ayuusweetfish/AICHO/hw/AICHO.kicad_pcb

## KiCad design hw/AICHO.kicad_pcb (2024-06-06)

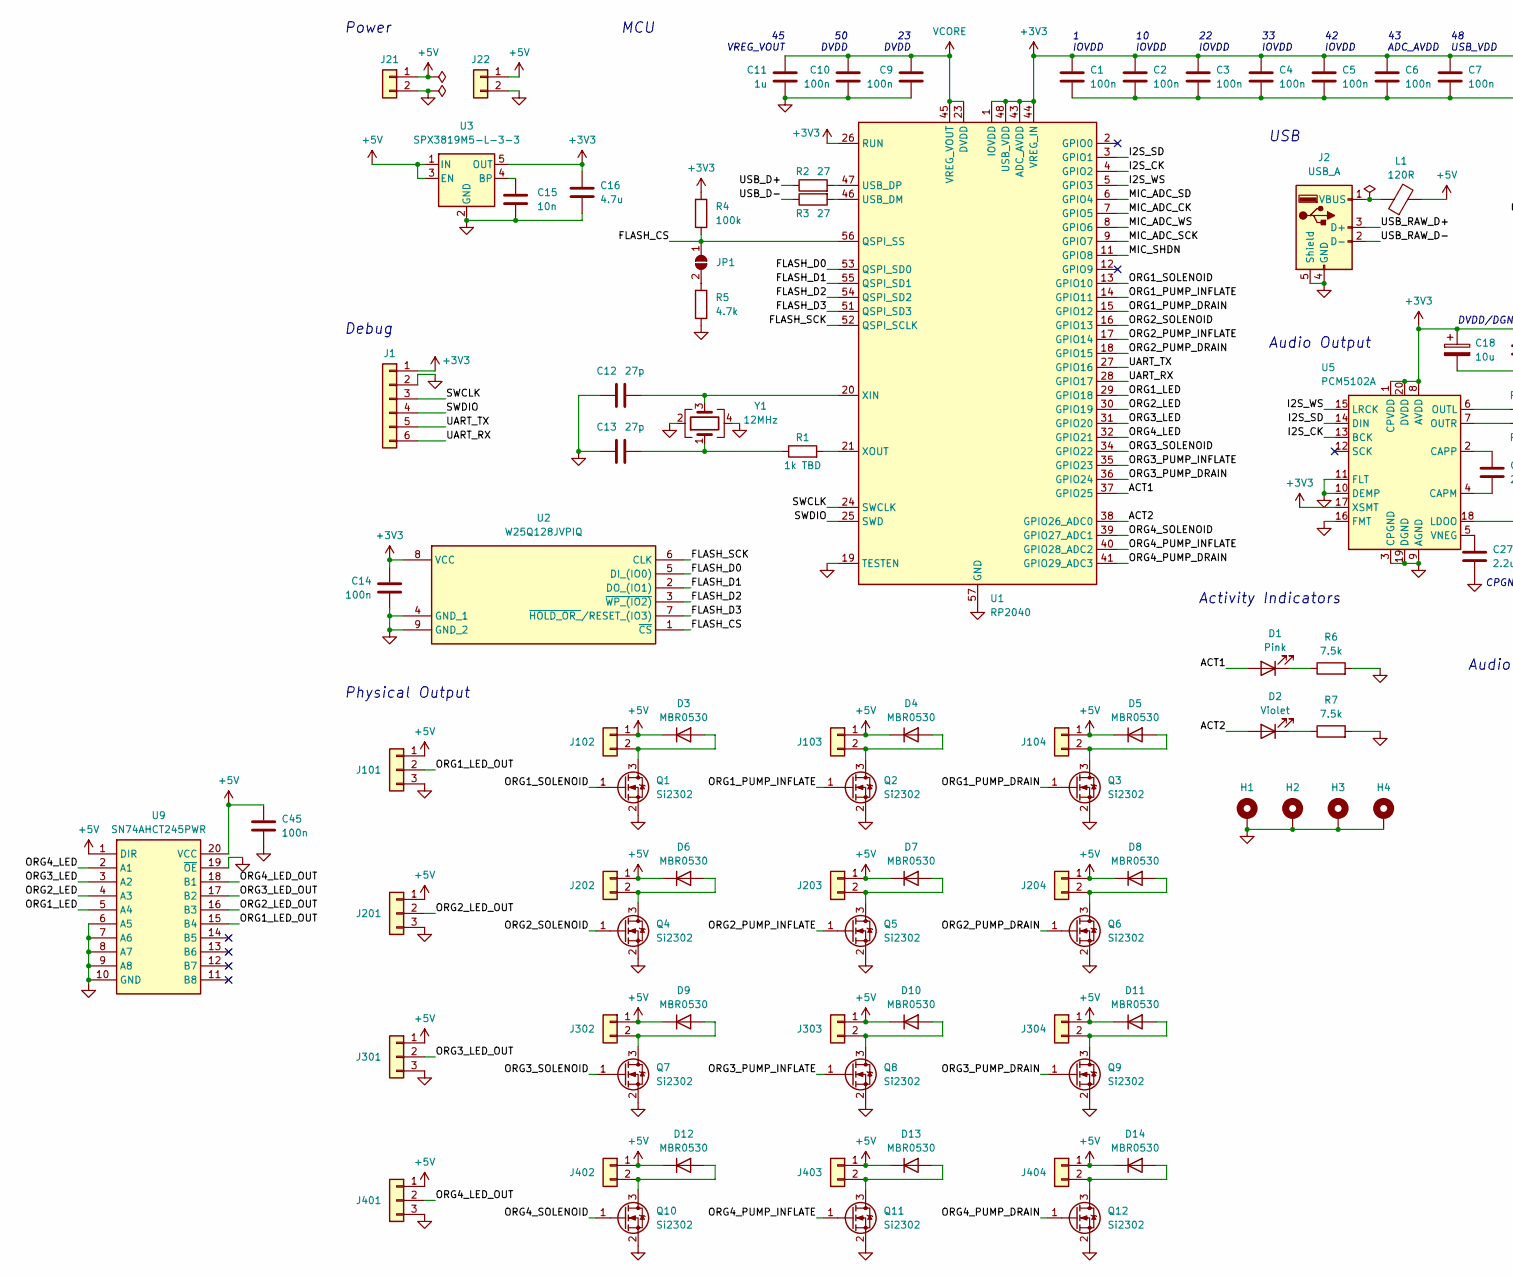
[picture p1: schematic AICHO.kicad_sch, part in row 1, column 1]

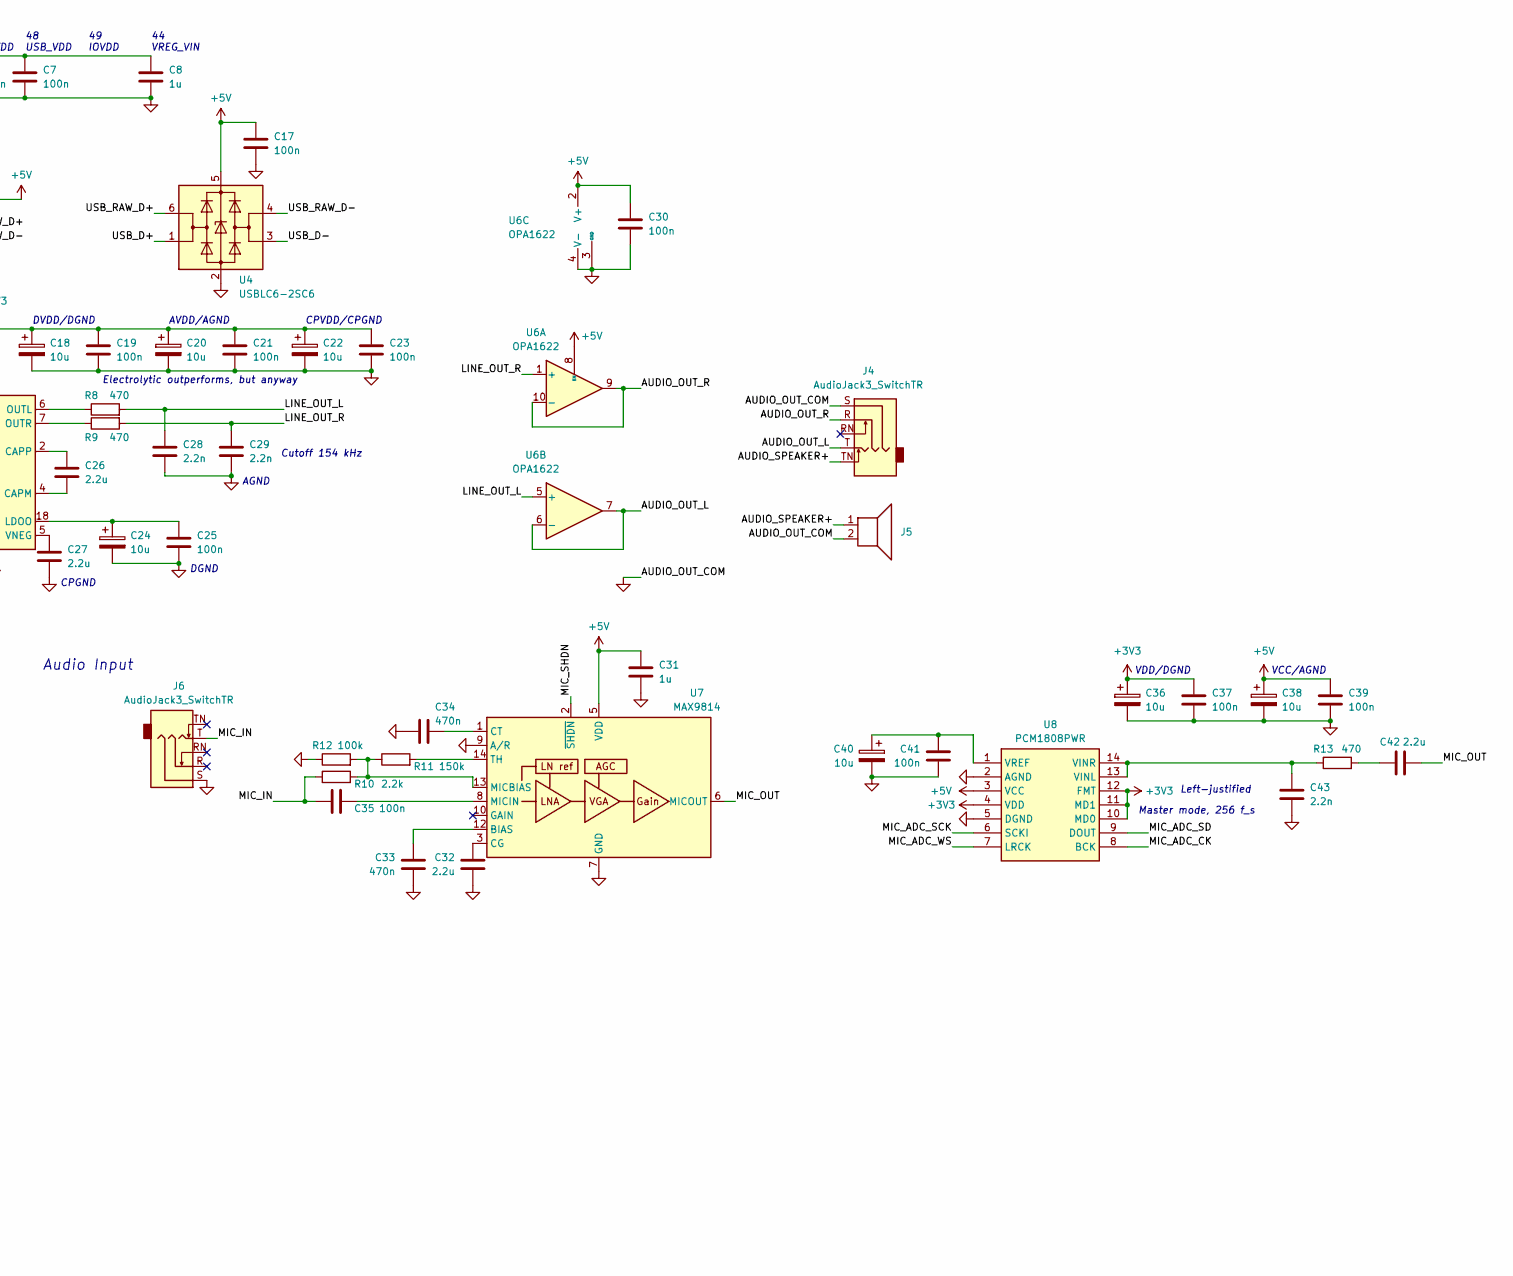
[picture p2: schematic AICHO.kicad_sch, part in row 1, column 2]

Parts:
C1, C2, C3, C4, C5, C6, C7, C9, C10, C14, C17, C19, C21, C23, C25, C30, C35, C37, C39, C41, C45: 100n; C_0402_1005Metric
C8, C11, C31: 1u; C_0402_1005Metric
C12, C13: 27p; C_0402_1005Metric
C15: 10n; C_0603_1608Metric
C16: 4.7u; C_0603_1608Metric
C18, C20, C22, C24, C36, C38, C40: 10u; C_0603_1608Metric
C26, C27, C32, C42: 2.2u; C_0402_1005Metric
C28, C29, C43: 2.2n; C_0402_1005Metric
C33, C34: 470n; C_0402_1005Metric
D1: Pink; LED_0603_1608Metric
D2: Violet; LED_0603_1608Metric
D3, D4, D5, D6, D7, D8, D9, D10, D11, D12, D13, D14: MBR0530; D_SOD-123
H1, H2, H3, H4: MountingHole_Pad; MountingHole_2.5mm_Pad_Via
J1: Conn_01x06; TestPoints_1x06_P2.0
J2: USB_A; USB_A_CNCTech_1001-011-01101_Horizontal
J4, J6: AudioJack3_SwitchTR; Jack_3.5mm_CUI_SJ1-3525N_Horizontal
J5: Speaker; PinHeader_1x02_P2.54mm_Vertical
J21, J22, J102, J103, J104, J202, J203, J204, J302, J303, J304, J402, J403, J404: Conn_01x02; PinHeader_1x02_P2.54mm_Vertical
J101, J201, J301, J401: Conn_01x03; PinHeader_1x03_P2.54mm_Vertical
JP1: SolderJumper_2_Open; SolderJumper-2_P1.3mm_Open_RoundedPad1.0x1.5mm
L1: 120R; L_0805_2012Metric
Q1, Q2, Q3, Q4, Q5, Q6, Q7, Q8, Q9, Q10, Q11, Q12: Si2302; SOT-23
R1: 1k TBD; R_0603_1608Metric
R2, R3: 27; R_0603_1608Metric
R4: 100k; R_0603_1608Metric
R5: 4.7k; R_0603_1608Metric
R6, R7: 7.5k; R_0603_1608Metric
R8, R9, R13: 470; R_0402_1005Metric
R10: 2.2k; R_0402_1005Metric
R11: 150k; R_0402_1005Metric
R12: 100k; R_0402_1005Metric
U1: RP2040; QFN-56-1EP_7x7mm_P0.4mm_EP3.2x3.2mm
U2: W25Q128JVPIQ; SON127P600X500X80-9N-D; Manufacturer_Part_Number W25Q128JVPIQ; Mouser Part Number 454-W25Q128JVPIQ
U3: SPX3819M5-L-3-3; SOT-23-5
U4: USBLC6-2SC6; SOT-23-6
U5: PCM5102A; TSSOP-20_4.4x6.5mm_P0.65mm
U6: OPA1622; Texas_S-PVSON-N10
U7: MAX9814; DFN-14-1EP_3x3mm_P0.4mm_EP1.78x2.35mm
U8: PCM1808PWR; Manufacturer_Part_Number PCM1808PWR; Mouser Part Number 595-PCM1808PWR
U9: SN74AHCT245PWR; SOP65P640X120-20N; Manufacturer_Part_Number SN74AHCT245PWR; Mouser Part Number 595-SN74AHCT245PWR
Y1: 12MHz; Crystal_SMD_3225-4Pin_3.2x2.5mm

Connections:
+3V3: C1.1, C2.1, C3.1, C4.1, C5.1, C6.1, C7.1, C8.1, C14.1, C16.1, C18.1, C19.1, C20.1, C21.1, C22.1, C23.1, C36.1, C37.1, J1.1, R4.2, U1.1 (IOVDD), U1.10 (IOVDD), U1.22 (IOVDD), U1.26 (RUN), U1.33 (IOVDD), U1.42 (IOVDD), U1.43 (ADC_AVDD), U1.44 (VREG_IN), U1.48 (USB_VDD), U1.49 (IOVDD), U2.8 (VCC), U3.5 (OUT), U5.1 (CPVDD), U5.8 (AVDD), U5.17 (XSMT), U5.20 (DVDD), U8.4 (VDD), U8.10 (MD0), U8.11 (MD1), U8.12 (FMT)
+5V: C17.1, C30.1, C31.1, C38.1, C39.1, C45.1, D3.1 (K), D4.1 (K), D5.1 (K), D6.1 (K), D7.1 (K), D8.1 (K), D9.1 (K), D10.1 (K), D11.1 (K), D12.1 (K), D13.1 (K), D14.1 (K), J21.1, J22.1, J101.1, J102.1, J103.1, J104.1, J201.1, J202.1, J203.1, J204.1, J301.1, J302.1, J303.1, J304.1, J401.1, J402.1, J403.1, J404.1, L1.2, U3.1 (IN), U3.3 (EN), U4.5 (VBUS), U6.2 (V+), U6.8 (EN), U7.5 (VDD), U8.3 (VCC), U9.1 (DIR), U9.20 (VCC)
/ACT1: D1.2 (A), U1.37 (GPIO25)
/ACT2: D2.2 (A), U1.38 (GPIO26_ADC0)
/AUDIO_OUT_L: J4.T, U6.6 (-), U6.7
/AUDIO_OUT_R: J4.R, U6.9, U6.10 (-)
/AUDIO_SPEAKER+: J4.TN, J5.1
/FLASH_CS: JP1.1 (A), R4.1, U1.56 (QSPI_SS), U2.1 (~CS)
/FLASH_D0: U1.53 (QSPI_SD0), U2.5 (DI_(IO0))
/FLASH_D1: U1.55 (QSPI_SD1), U2.2 (DO_(IO1))
/FLASH_D2: U1.54 (QSPI_SD2), U2.3 (~WP_(IO2))
/FLASH_D3: U1.51 (QSPI_SD3), U2.7 (~HOLD_OR_/RESET_(IO3))
/FLASH_SCK: U1.52 (QSPI_SCLK), U2.6 (CLK)
/I2S_CK: U1.4 (GPIO2), U5.13 (BCK)
/I2S_SD: U1.3 (GPIO1), U5.14 (DIN)
/I2S_WS: U1.5 (GPIO3), U5.15 (LRCK)
/LINE_OUT_L: C28.1, R8.2, U6.5 (+)
/LINE_OUT_R: C29.1, R9.2, U6.1 (+)
/MIC_ADC_CK: U1.7 (GPIO5), U8.8 (BCK)
/MIC_ADC_SCK: U1.9 (GPIO7), U8.6 (SCKI)
/MIC_ADC_SD: U1.6 (GPIO4), U8.9 (DOUT)
/MIC_ADC_WS: U1.8 (GPIO6), U8.7 (LRCK)
/MIC_IN: C35.1, J6.T, R10.1
/MIC_OUT: C42.2, U7.6 (MICOUT)
/MIC_SHDN: U1.11 (GPIO8), U7.2 (~SHDN)
/ORG1_LED: U1.29 (GPIO18), U9.5 (A4)
/ORG1_LED_OUT: J101.2, U9.15 (B4)
/ORG1_PUMP_DRAIN: Q3.1 (G), U1.15 (GPIO12)
/ORG1_PUMP_INFLATE: Q2.1 (G), U1.14 (GPIO11)
/ORG1_SOLENOID: Q1.1 (G), U1.13 (GPIO10)
/ORG2_LED: U1.30 (GPIO19), U9.4 (A3)
/ORG2_LED_OUT: J201.2, U9.16 (B3)
/ORG2_PUMP_DRAIN: Q6.1 (G), U1.18 (GPIO15)
/ORG2_PUMP_INFLATE: Q5.1 (G), U1.17 (GPIO14)
/ORG2_SOLENOID: Q4.1 (G), U1.16 (GPIO13)
/ORG3_LED: U1.31 (GPIO20), U9.3 (A2)
/ORG3_LED_OUT: J301.2, U9.17 (B2)
/ORG3_PUMP_DRAIN: Q9.1 (G), U1.36 (GPIO24)
/ORG3_PUMP_INFLATE: Q8.1 (G), U1.35 (GPIO23)
/ORG3_SOLENOID: Q7.1 (G), U1.34 (GPIO22)
/ORG4_LED: U1.32 (GPIO21), U9.2 (A1)
/ORG4_LED_OUT: J401.2, U9.18 (B1)
/ORG4_PUMP_DRAIN: Q12.1 (G), U1.41 (GPIO29_ADC3)
/ORG4_PUMP_INFLATE: Q11.1 (G), U1.40 (GPIO28_ADC2)
/ORG4_SOLENOID: Q10.1 (G), U1.39 (GPIO27_ADC1)
/SWCLK: J1.3, U1.24 (SWCLK)
/SWDIO: J1.4, U1.25 (SWD)
/UART_RX: J1.6, U1.28 (GPIO17)
/UART_TX: J1.5, U1.27 (GPIO16)
/USB_D+: R2.1, U4.1 (I/O1)
/USB_D-: R3.1, U4.3 (I/O2)
/USB_RAW_D+: J2.3 (D+), U4.6 (I/O1)
/USB_RAW_D-: J2.2 (D-), U4.4 (I/O2)
GND: C1.2, C2.2, C3.2, C4.2, C5.2, C6.2, C7.2, C8.2, C9.2, C10.2, C11.2, C12.1, C13.1, C14.2, C15.2, C16.2, C17.2, C18.2, C19.2, C20.2, C21.2, C22.2, C23.2, C24.2, C25.2, C27.2, C28.2, C29.2, C30.2, C31.2, C32.2, C33.2, C34.2, C36.2, C37.2, C38.2, C39.2, C40.2, C41.2, C43.2, C45.2, H1.1, H2.1, H3.1, H4.1, J1.2, J2.4 (GND), J2.5 (Shield), J4.S, J5.2, J6.S, J21.2, J22.2, J101.3, J201.3, J301.3, J401.3, Q1.2 (S), Q2.2 (S), Q3.2 (S), Q4.2 (S), Q5.2 (S), Q6.2 (S), Q7.2 (S), Q8.2 (S), Q9.2 (S), Q10.2 (S), Q11.2 (S), Q12.2 (S), R5.1, R6.2, R7.2, R12.1, U1.19 (TESTEN), U1.57 (GND), U2.4 (GND_1), U2.9 (GND_2), U3.2 (GND), U4.2 (GND), U5.3 (CPGND), U5.9 (AGND), U5.10 (DEMP), U5.11 (FLT), U5.16 (FMT), U5.19 (DGND), U6.3 (GND), U6.4 (V-), U6.11 (V-), U7.4 (GND), U7.7 (GND), U7.9 (A/R), U7.11 (GND), U7.15 (GND), U8.2 (AGND), U8.5 (DGND), U9.6 (A5), U9.7 (A6), U9.8 (A7), U9.9 (A8), U9.10 (GND), U9.19 (~OE), Y1.2, Y1.4
unnamed: C13.2, R1.1, Y1.1
unnamed: C42.1, R13.2
unnamed: D1.1 (K), R6.1
unnamed: D2.1 (K), R7.1
unnamed: D3.2 (A), J102.2, Q1.3 (D)
unnamed: D4.2 (A), J103.2, Q2.3 (D)
unnamed: D5.2 (A), J104.2, Q3.3 (D)
unnamed: D6.2 (A), J202.2, Q4.3 (D)
unnamed: D7.2 (A), J203.2, Q5.3 (D)
unnamed: D8.2 (A), J204.2, Q6.3 (D)
unnamed: D9.2 (A), J302.2, Q7.3 (D)
unnamed: D10.2 (A), J303.2, Q8.3 (D)
unnamed: D11.2 (A), J304.2, Q9.3 (D)
unnamed: D12.2 (A), J402.2, Q10.3 (D)
unnamed: D13.2 (A), J403.2, Q11.3 (D)
unnamed: D14.2 (A), J404.2, Q12.3 (D)
unnamed: J2.1 (VBUS), L1.1
unnamed: JP1.2 (B), R5.2
unnamed: R3.2, U1.46 (USB_DM)
unnamed: R2.2, U1.47 (USB_DP)
unnamed: C12.2, U1.20 (XIN), Y1.3
unnamed: R1.2, U1.21 (XOUT)
unnamed: C15.1, U3.4 (BP)
unnamed: C26.2, U5.4 (CAPM)
unnamed: C26.1, U5.2 (CAPP)
unnamed: C24.1, C25.1, U5.18 (LDOO)
unnamed: R8.1, U5.6 (OUTL)
unnamed: R9.1, U5.7 (OUTR)
unnamed: C27.1, U5.5 (VNEG)
unnamed: C33.1, U7.12 (BIAS)
unnamed: C32.1, U7.3 (CG)
unnamed: C34.1, U7.1 (CT)
unnamed: R10.2, R11.1, R12.2, U7.13 (MICBIAS)
unnamed: C35.2, U7.8 (MICIN)
unnamed: R11.2, U7.14 (TH)
unnamed: C43.1, R13.1, U8.13 (VINL), U8.14 (VINR)
unnamed: C40.1, C41.1, U8.1 (VREF)
VCORE: C9.1, C10.1, C11.1, U1.23 (DVDD), U1.45 (VREG_VOUT), U1.50 (DVDD)

Notes on the sheet:
Power
AVDD/AGND
33 IOVDD
1 IOVDD
48 USB_VDD
Debug
22 IOVDD
42 IOVDD
AGND
USB
VDD/DGND
CPVDD/CPGND
Electrolytic outperforms, but anyway
50 DVDD
44 VREG_VIN
DVDD/DGND
49 IOVDD
Physical Output
Audio Output
Left-justified
45 VREG_VOUT
Activity Indicators
VCC/AGND
DGND
23 DVDD
Cutoff 154 kHz
10 IOVDD
CPGND
43 ADC_AVDD
Master mode, 256 f_s
MCU
Audio Input

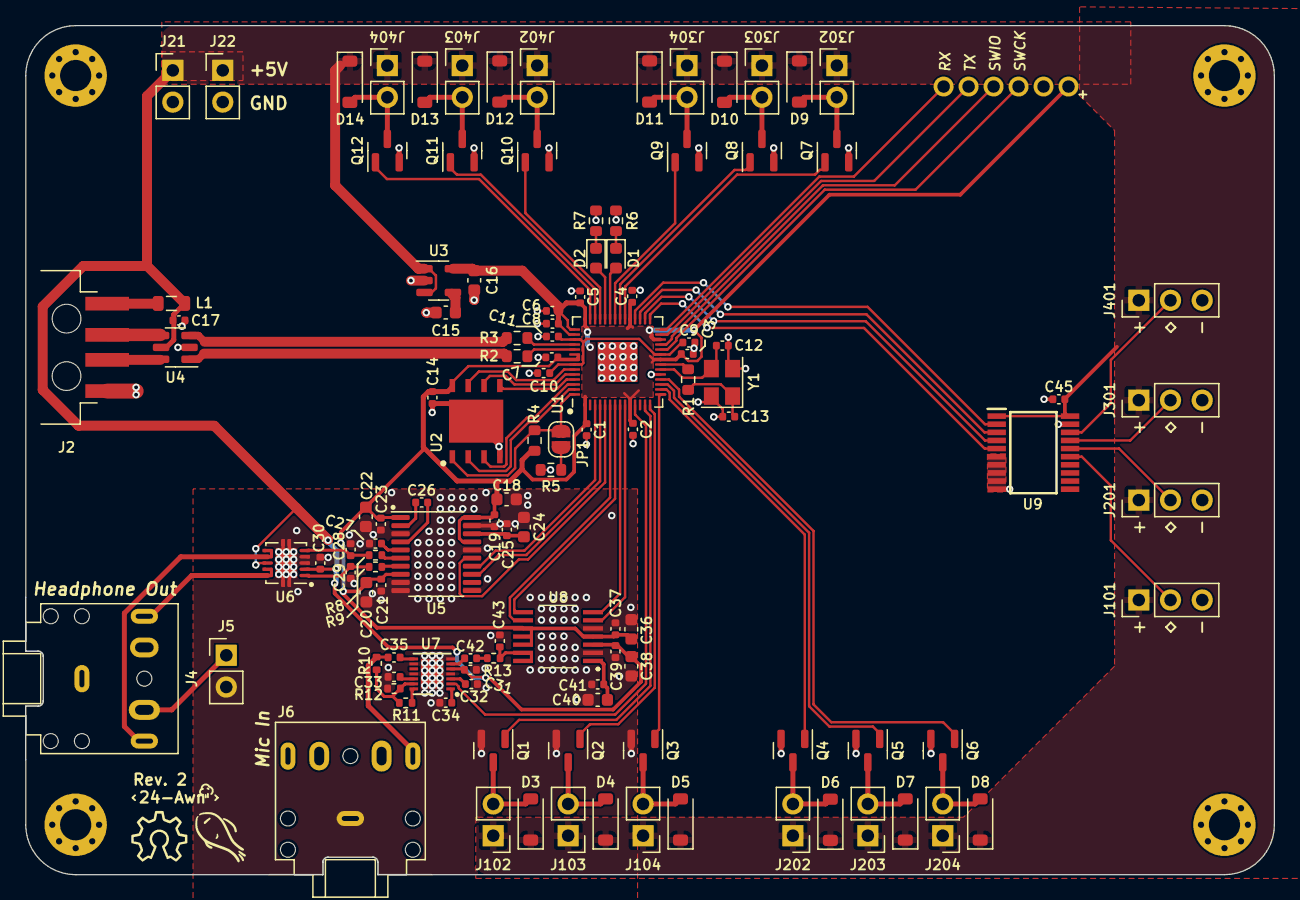
[picture p3: board AICHO.kicad_pcb from above]

Board: 2 copper layers, 100.0 x 68.0 mm, 122 parts (0 on the bottom side), 92 nets.
