ayuusweetfish/AICHO/fw/src/main.h

#pragma once

#include <stdbool.h>
#include <stdint.h>

#ifndef BOARD_REV
  // Rev. 1, 1a - 1
  // Rev. 2     - 2
  #define BOARD_REV 2
#endif

#if BOARD_REV == 1
  #define act_1 22
  #define act_2 23
#elif BOARD_REV == 2
  #define act_1 25
  #define act_2 26
#endif

// main.c
int my_printf(const char *restrict fmt, ...);
extern bool breath_signal;

// fft.c
#define FFT_N 2048
void fft_init();
void fft(const int32_t *restrict in, int32_t *restrict out);

// usb_host.c
extern bool org_key[4];
