ayuusweetfish/AICHO/(commit log)

2024-05-29 🎉 Parts of schematics
    [AICHO.kicad_pcb, AICHO.kicad_sch]
2024-05-29 Add motor unit test firmware (based on Malletwand sub-unit)
2024-05-29 Finish board schematic
    [AICHO.kicad_sch]
2024-05-29 Set amplifier IC to minimum gain
    Ref. https://ez.analog.com/audio/f/q-a/569114/max98357-headphone-circuit
    [AICHO.kicad_sch]
2024-05-30 🚧 Layout
    [AICHO.kicad_pcb, AICHO.kicad_sch]
2024-05-30 🚧 More layout
    [AICHO.kicad_pcb, AICHO.kicad_sch]
2024-05-30 🚧 More layout?
    [AICHO.kicad_pcb, AICHO.kicad_sch]
2024-05-30 Finish layout and routing
    [AICHO.kicad_pcb, AICHO.kicad_sch]
2024-05-31 More routing (is this perfectionism??)
    [AICHO.kicad_pcb, AICHO.kicad_sch]
2024-05-31 Place silkscreen text
    [AICHO.kicad_pcb]
2024-05-31 Finalise board design; submit for fab
    [AICHO.kicad_pcb]
2024-05-31 Fix missing level shifter and resubmit for fab >-<
    [AICHO.kicad_pcb, AICHO.kicad_sch]
2024-06-01 Add audio processor sample (spectrogram)
2024-06-01 More processing…?
2024-06-02 More analyses…
2024-06-03 Move (unused) motor unit firmware to misc/
2024-06-03 Print to UART
2024-06-03 Fix GPIO mux not set up for PIO output
    [main.c]
2024-06-04 Running on the real board!
2024-06-04 🔊 Output white noise!
    [main.c]
2024-06-04 ∿ Output a sine wave
2024-06-04 Writing to PIO with DMA
2024-06-04 Chaining DMA channels to get a double buffer
2024-06-04 Switch to 16-bit mono PCM representation, reducing memory bandwidth
2024-06-05 Pause and resume DMA transfers
2024-06-05 🎶 Sampler!
2024-06-05 (🚧 Untested) Drive WS2812
2024-06-05 Correctly outputting LED signals
    [main.c]
2024-06-05 Polyphonic sampler
2024-06-06 🚧 Revise schematic
    [AICHO.kicad_sch]
2024-06-06 🚧 Update layout
    [AICHO.kicad_pcb, AICHO.kicad_sch]
2024-06-06 Finish updated board layout & routing
    [AICHO.kicad_pcb, AICHO.kicad_sch]
2024-06-06 Yes, this is
    [AICHO.kicad_pcb]
2024-06-06 I don't believe it's perfect but submit for fab (Rev. 2)
    [AICHO.kicad_pcb]
2024-06-06 Driving LED strip with given colours
2024-06-07 Switch everything uQOA-related to little-endian
2024-06-07 Revert to 32-bit (s16 stereo) audio
    [main.c]
2024-06-08 Driving solenoids and pumps!
2024-06-09 Start to adapt firmware for updated board
2024-06-09 Support both board revisions by preprocessor switch
2024-06-09 Adapt solenoid/pump gate pins to rev. 1a board
2024-06-10 USB confirmed working on updated board
2024-06-10 Fix LED strip driver DMA DREQ
    [main.c]
2024-06-10 🚧 I2S reading all zeroes??
2024-06-10 🚧 Seemingly legit outputs, but not changing with microphone?
2024-06-10 Properly reading microphone amplifier output
    (Tested by shorting LINE_OUT_L and filtered MIC_OUT)
    [main.c]
2024-06-10 Move WS2812 driver onto PIO block 0
2024-06-10 Just a filter Bode plot
2024-06-11 🎙️ Microphone working!
2024-06-11 Run FFT and audio output on core 1
    🚧 Optimisation to-do (try cache-friendliness of flash?)
2024-06-12 🚧 Optimisations in progress!
2024-06-12 Reduce jitter in processing due to excessive time spent in samplers
    [main.c, uqoa.h]
2024-06-13 Revise signals, supporting leak mode
    [main.c]
2024-06-13 🚧 Filter audio
2024-06-13 Finally an accurate enough filtering algorithm?
2024-06-13 Improve pump management robustness with time-consuming TinyUSB calls
2024-06-13 Distinguish long and short keystrokes
    [main.c]
2024-06-13 Use a queue for sampler triggers to reduce critical section length
2024-06-13 Add LED strip colours (Lorivox)
2024-06-13 More LED patterns (Harmonia, Titanus)
2024-06-13 Switch to leak (instead of drain) on short trigger's end
    [main.c]
2024-06-14 (🚧 Untested) Implement stereo sampler
2024-06-14 🚧 Breath rate estimator
2024-06-15 Receive additional key signals from UART
2024-06-15 Add keyboard relay through UART
2024-06-15 Finish computer serial sender (keyboard relay)
2024-06-15 Move (now unused) keyboard relay firmware to misc/
2024-06-15 Add in-house testing compilation switch
2024-06-15 Filter more
2024-06-15 Finish synchronised echoes by lights and air pumps
2024-06-16 Update serial relay to support Pico debug probe
2024-06-16 Update LED unit count to match installation iteration
2024-06-16 Avoid overheating valves on startup
    [main.c]
